jerryryle/a-roma/ABOUT.md

# About A-Roma (August 2025)

You can find more technical detail in [README.md](/README.md).

I thought it would be fun to prank my boss when he came back from a two-week vacation to Italy. While he was gone, my coworkers decorated his desk with an Italian theme. I decided that his desk also needed a way to dispense Italian-themed smells and music so that he could enjoy the sights, sounds, and smells of his trip when he returned.

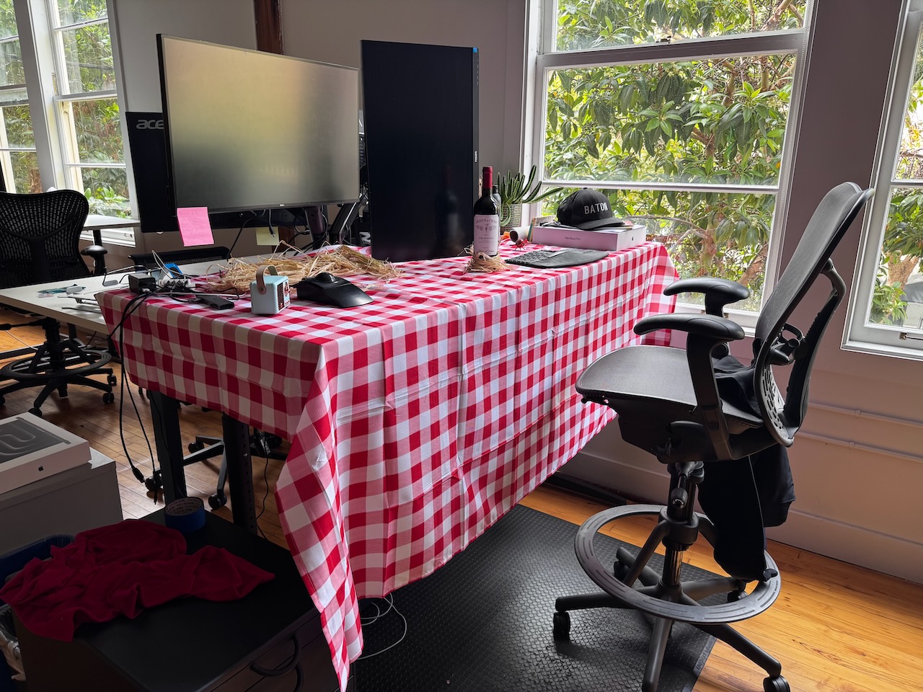
[picture p1: media/img-desk.jpeg]
My boss's desk Photo of my boss's desk, decorated with an Italian theme


The night before he returned, I loaded the device with scents and mounted it under his desk.

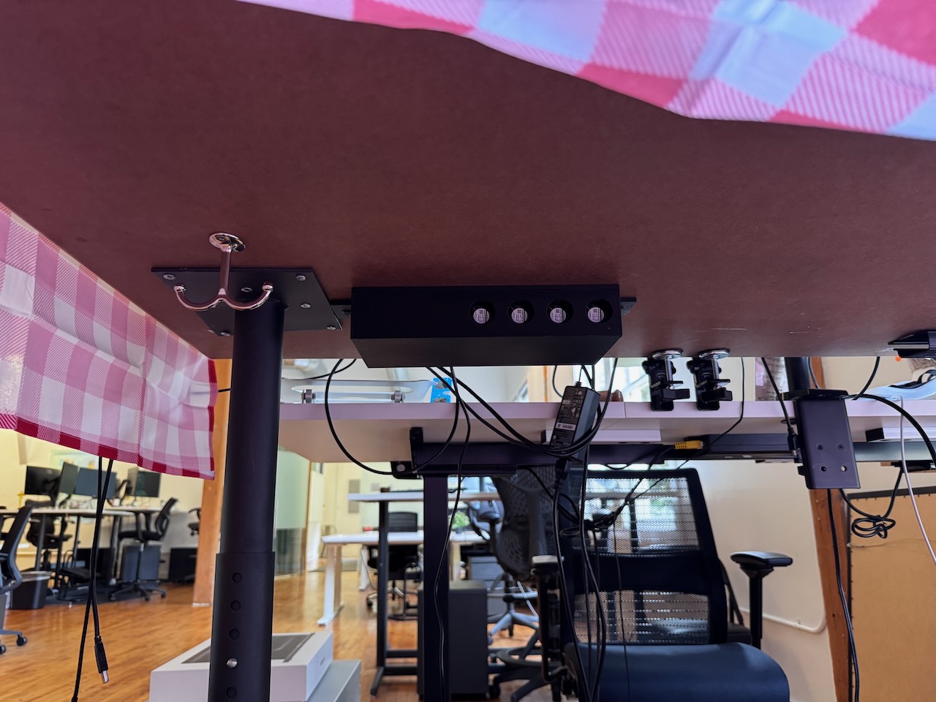
[picture p2: media/img-mounted.jpeg]
The device mounted under his desk Photo of the device mounted under his desk


The morning my boss returned, I created a private Slack channel that included everyone in the company except him. I told everyone what was happening and gave them the link to the device's website that they could use to trigger the dispensation of smells. And they did. Relentlessly. We had hours of fine Italian leather, artisan bread, espresso, and garlic. It backfired a bit since my boss was in meetings most of the day and I was sitting downwind of his desk. But we did see him sniffing around and asking others if they smelled something weird.

I had anticipated that there was a good chance he wouldn't go looking for the source of the smells and find the box, so I built in an escalation feature to help him discover it. This included a small speaker and software to play four campy Italian songs.

After a day of gassing the office, I finally decided to bring it to an end. I distributed a new link to everyone that added buttons to trigger the songs. It so happened that I chose songs he had loaded onto his phone for his trip. When they started playing, he thought they were coming from his phone and grabbed it to shut them off. When he realized his phone wasn't playing them, he started searching around his desk (while we madly blasted garlic), found the box, and yanked the power cord. The whole office was laughing at this point. I could hardly breathe--mostly from laughing, but also because of the garlic.

To wrap it up, I invited him into the Slack channel where he could see all of our plotting throughout the day. In that channel, I had posted a “making of” thread that went into detail about how I designed and built the device. Enjoy that below.

## The Making Of
The project began with reconnaissance to see how much space I had to work with. I needed dimensions for the area and to evaluate the angle of approach to ensure the box wasn't too deep or obvious. At this point, I didn't know the table would sport a tablecloth to help hide it.

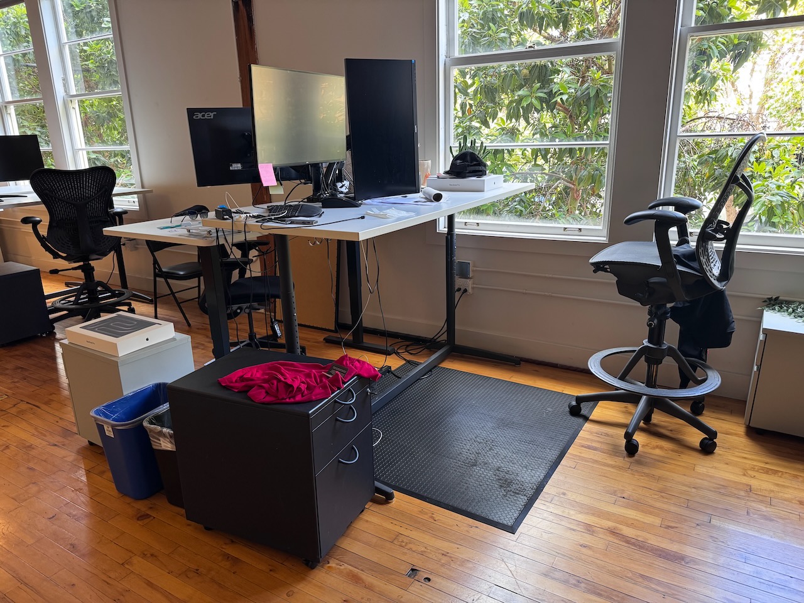
[picture p3: media/img-measuring-ryans-desk-approach.jpeg]
Checking out the angle of approach Photo of my boss's desk as one would walk up to it


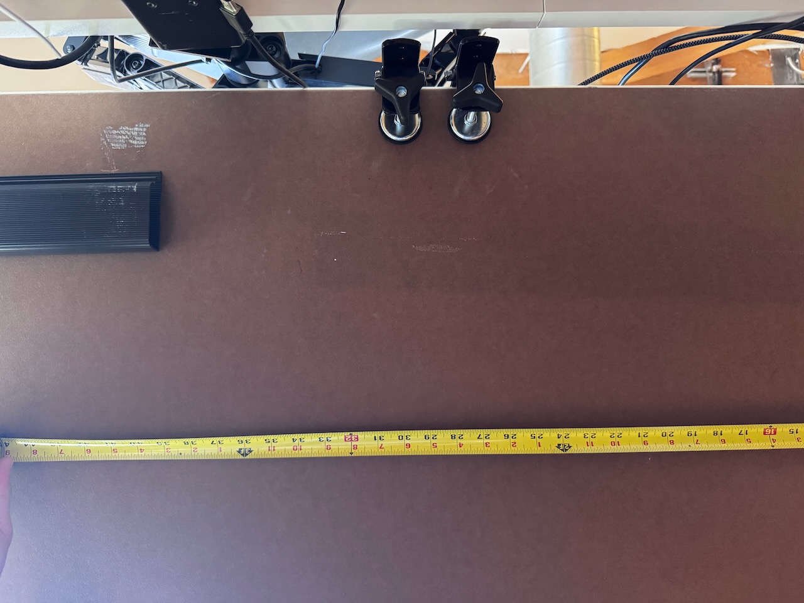
[picture p4: media/img-measuring-ryans-desk.jpeg]
Measuring how much space I had to work with Photo of holding a tape measure under the desk


Then I had to find small, quiet fans that moved a reasonable amount of air.

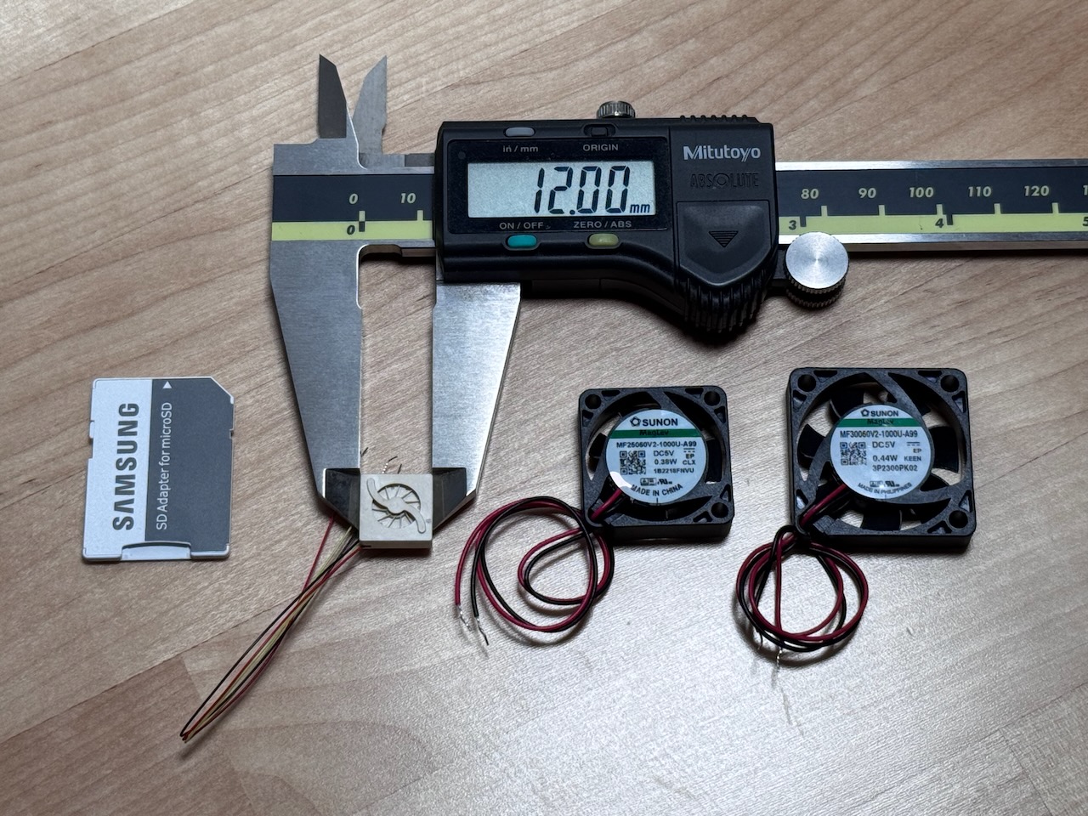
[picture p5: media/img-fan-sizing.jpeg]
I got an assortment of fan sizes Photo of fans of varying size


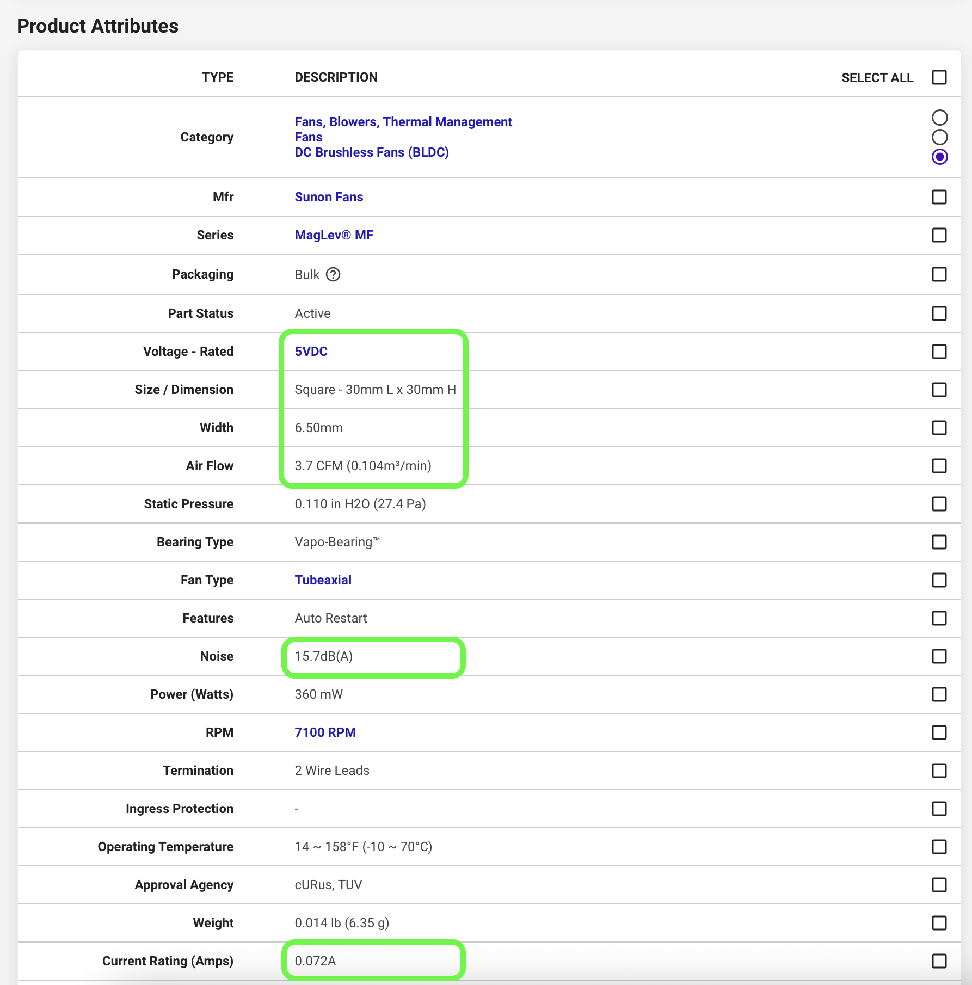
[picture p6: media/img-digikey-fan.png]
Inspecting relevant fan specifications Screenshot of DigiKey page with voltage, size, width, air flow, noise, and current rating circled


That tiny fan was ridiculous.

I modeled each aroma channel, anchoring around the fan size.

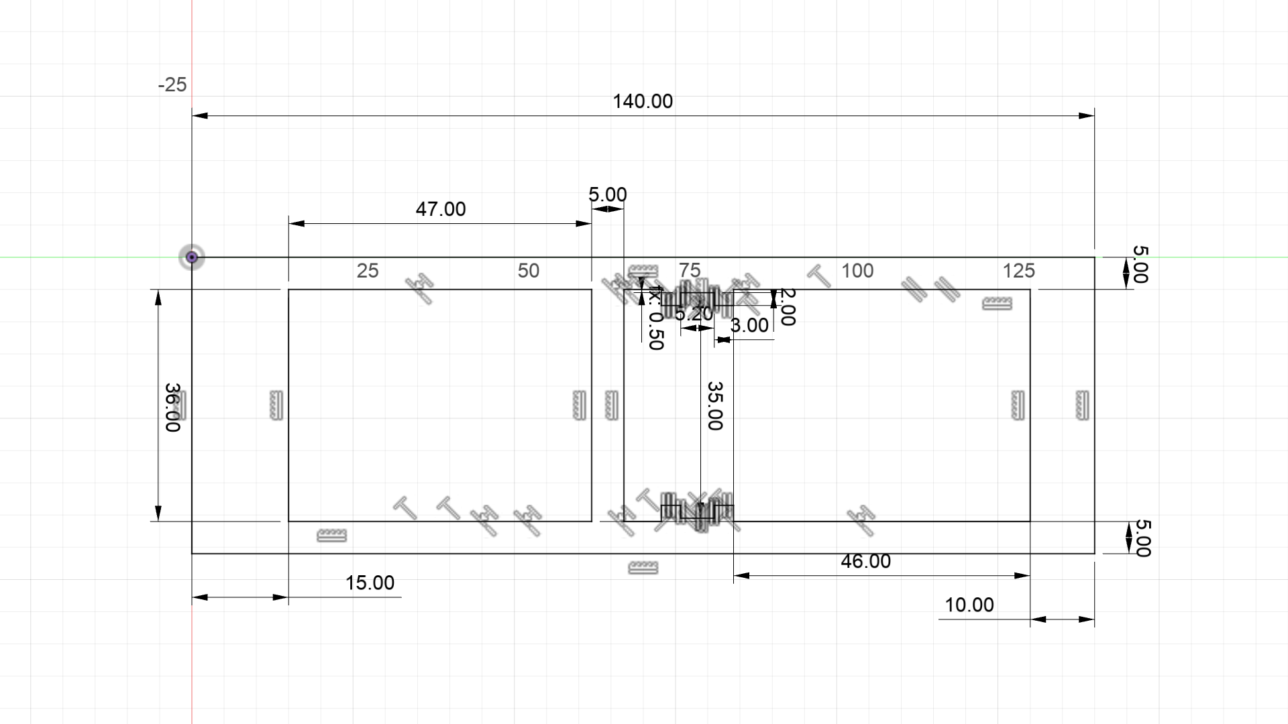
[picture p7: media/2D-chassis-channel.png]
Drawing of the aroma channel Screenshot of a 2D CAD drawing of the aroma channel


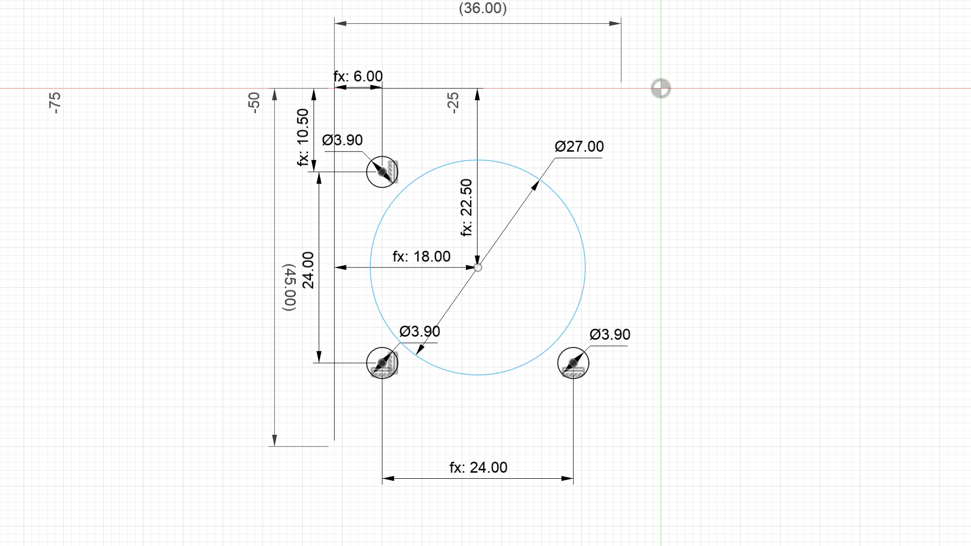
[picture p8: media/2D-chassis-fan.png]
Drawing of the fan cutout and mounting holes Screenshot of a 2D CAD drawing of the fan cutout and mounting holes


I found some aromatherapy oil pads that were roughly the size of the fan.

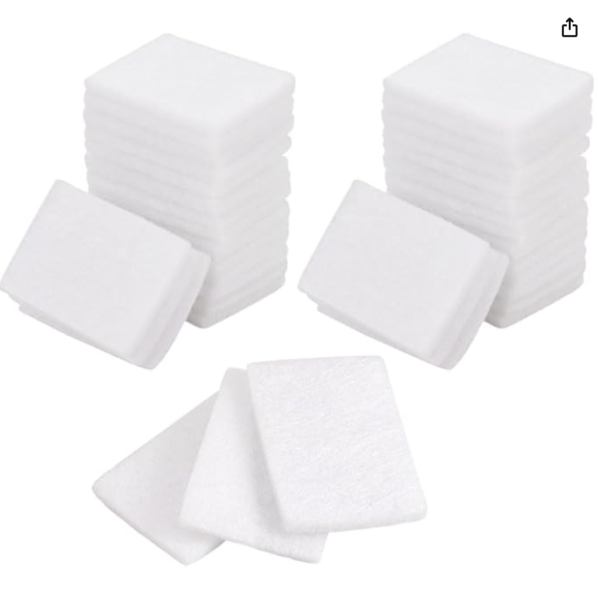
[picture p9: media/img-aromatherapy-pads.png]
Aromatherapy pads Photo of stacks of aromatherapy pads


And modeled a holder for them.

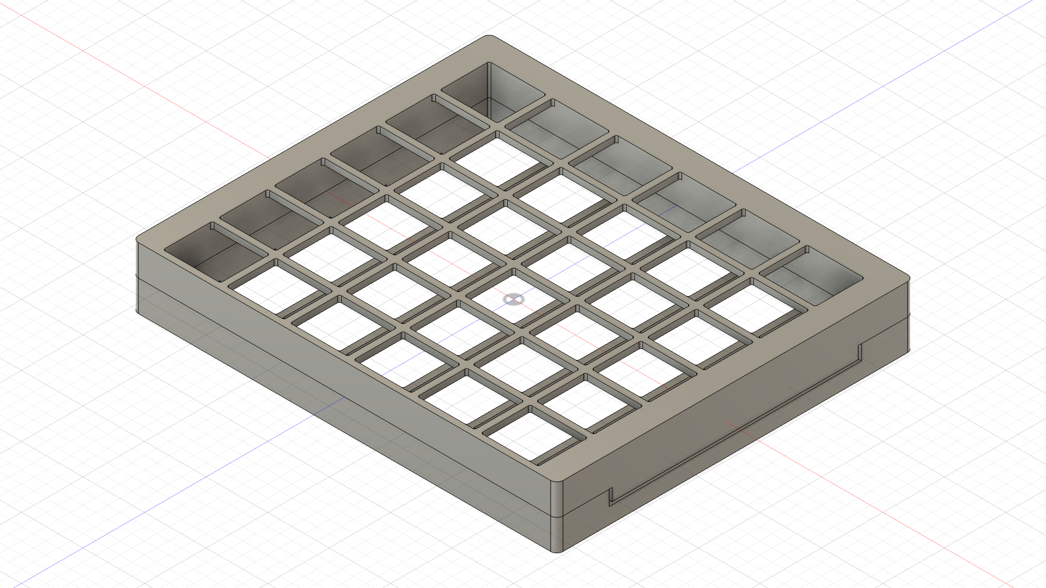
[picture p10: media/3D-filter-holder.png]
Pad holder Screenshot of a 3D CAD rendering of the pad holder


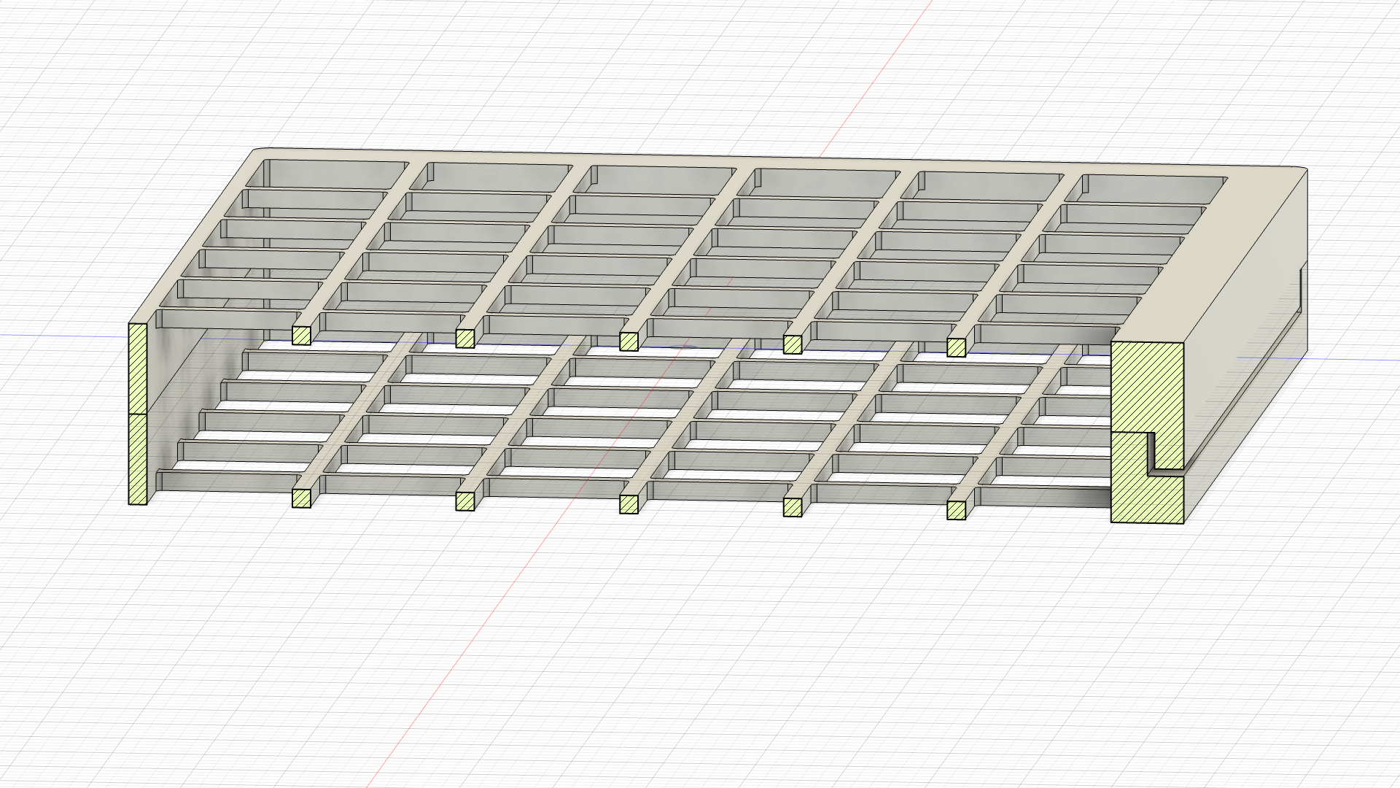
[picture p11: media/3D-filter-holder-section-analysis.png]
Pad holder section analysis Screenshot of a 3D CAD rendering of the pad holder, sliced to show how the two halves mate


The chassis is an array of four channels modeled around the fans and oil pads, with a separate space for the electronics.

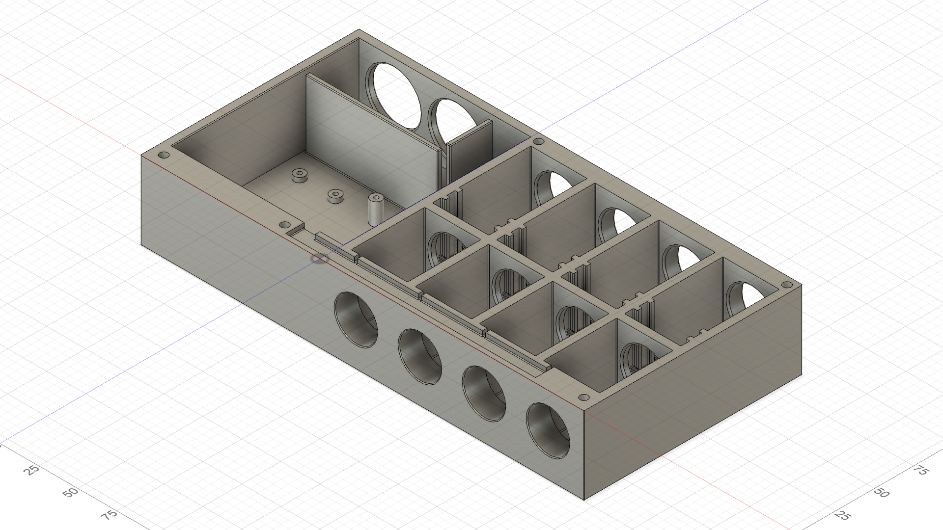
[picture p12: media/3D-chassis.png]
Chassis Screenshot of a 3D CAD rendering of the chassis


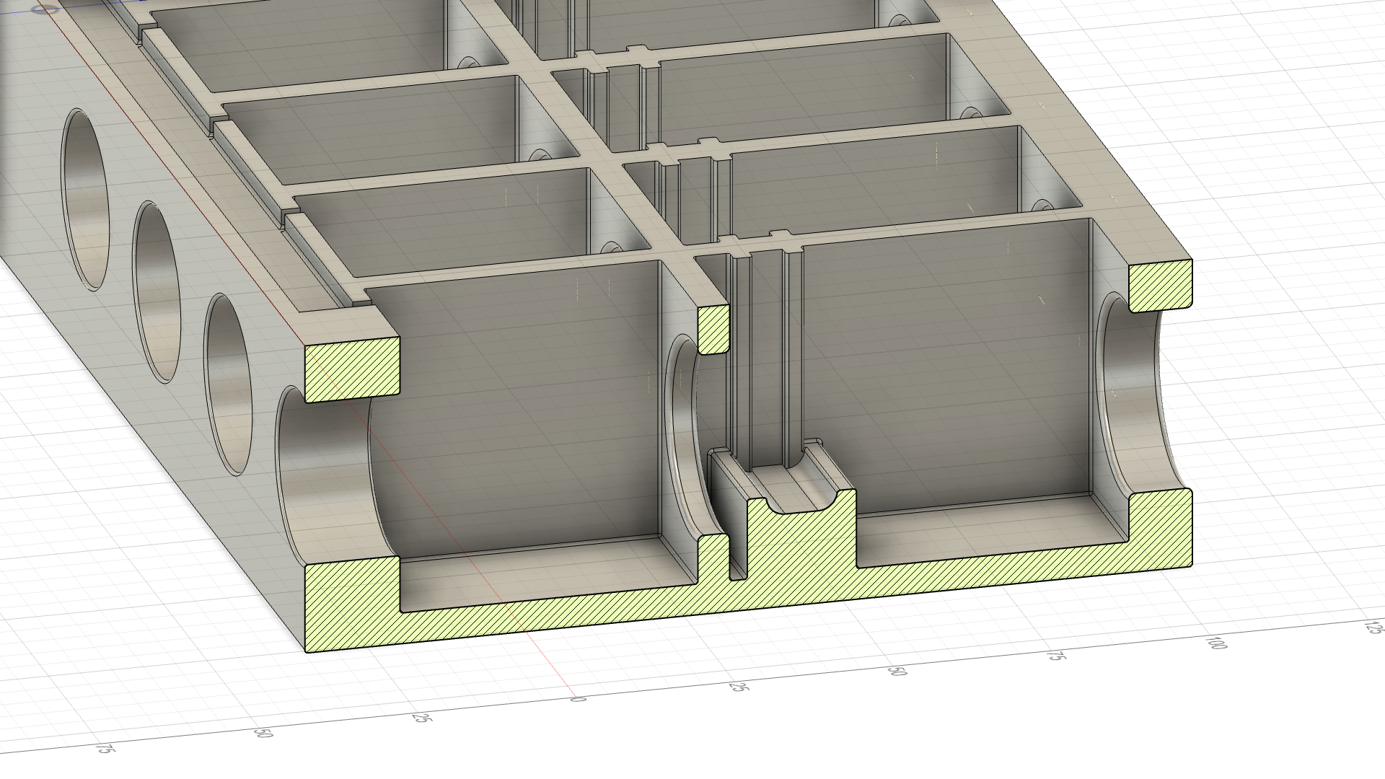
[picture p13: media/3D-chassis-section-analysis.png]
Chassis section analysis Screenshot of a 3D CAD rendering of the pad holder, sliced to show the channel details


I printed the chassis, lid, and oil pad holders with PETG plastic, one of the more oil-resistant plastics that's not too difficult to 3D print.

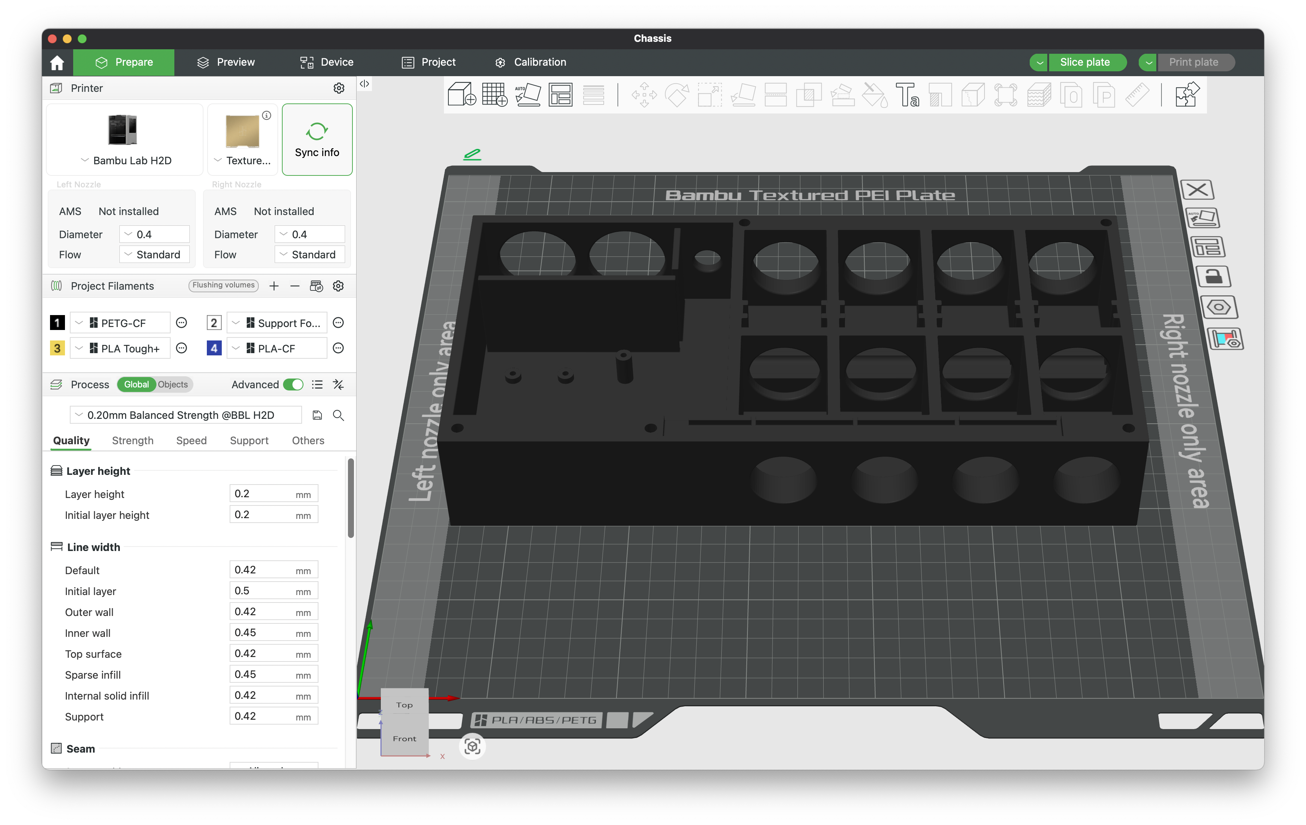
[picture p14: media/bambu-3dprint-chassis.png]
Chassis print preparation Screenshot of the Chassis in Bambu Studio


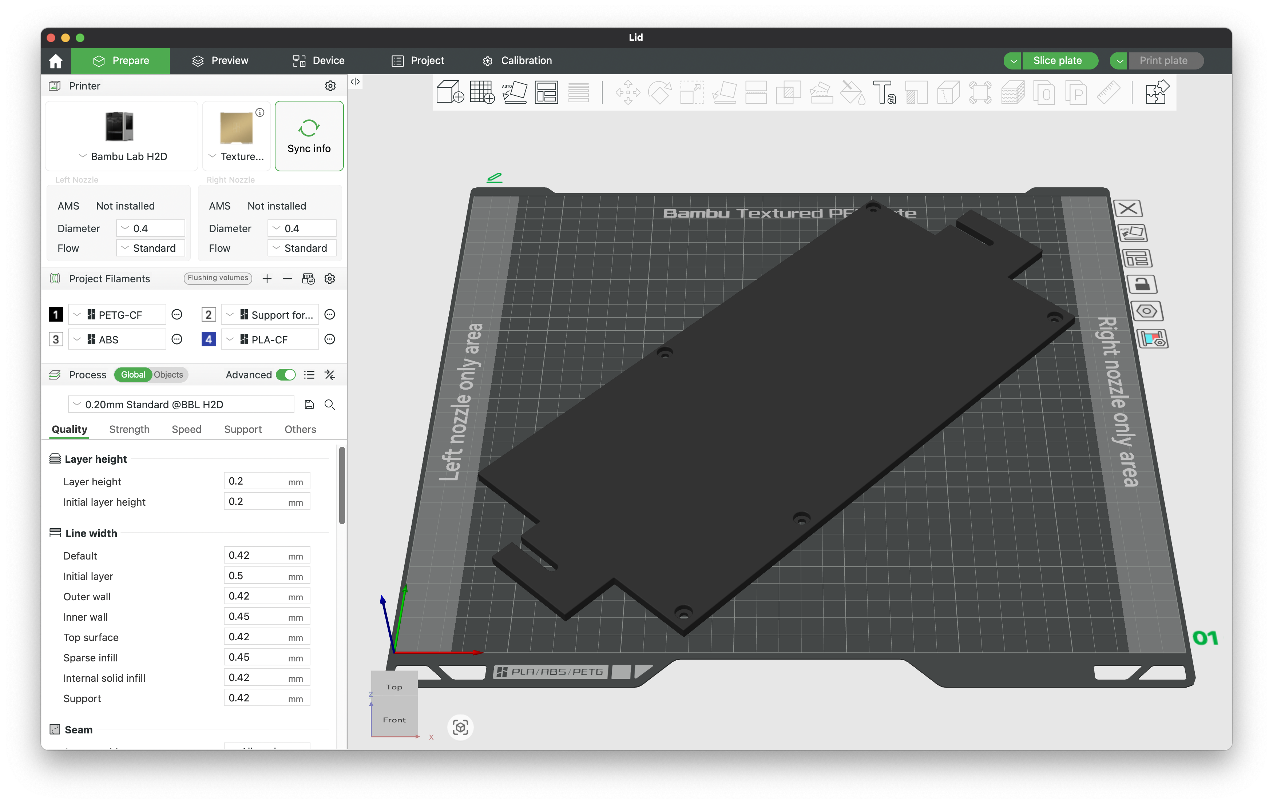
[picture p15: media/bambu-3dprint-lid.png]
Lid print preparation Screenshot of the Lid in Bambu Studio


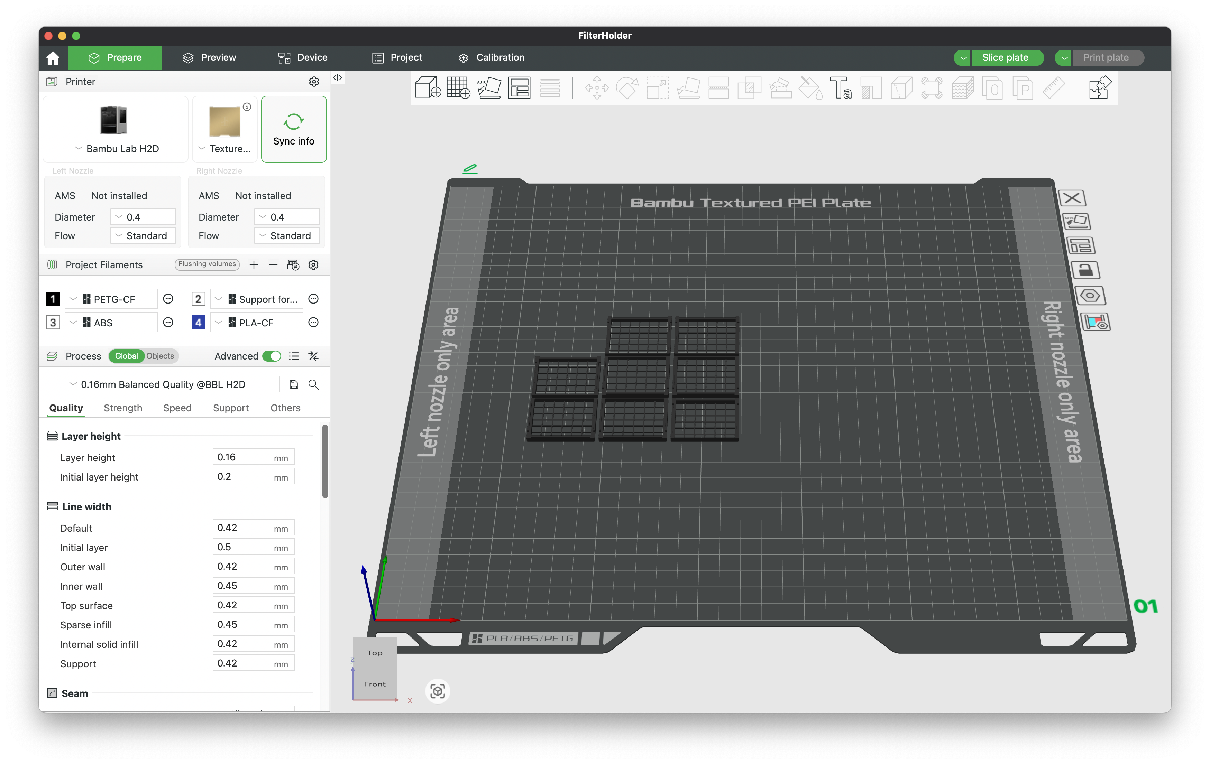
[picture p16: media/bambu-3dprint-filter-holder.png]
Pad holder print preparation Screenshot of the Pad Holders in Bambu Studio


These were all printed on a Bambu Labs H2D, which takes time lapses of the prints.

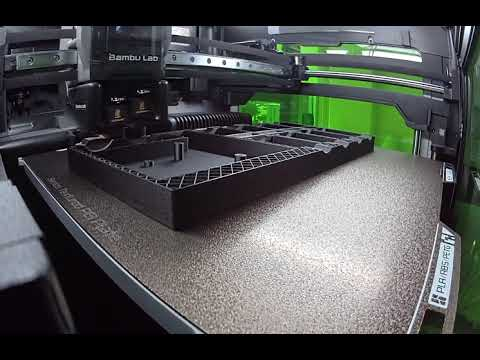
[picture p17: media/img-print-chassis-final.jpeg]
Chassis Time lapse video of the Chassis 3D printing (https://youtu.be/BnPhF0Df4So)


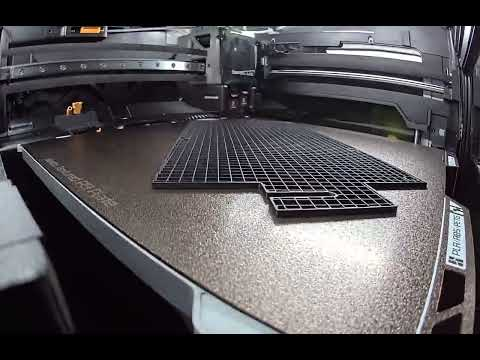
[picture p18: media/img-print-lid-final.jpeg]
Lid Time lapse video of the Lid 3D printing (https://youtu.be/3ELbYYBSLHE)


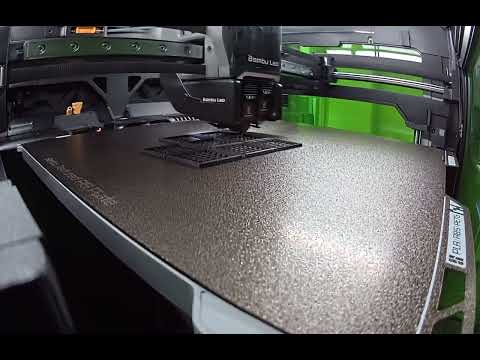
[picture p19: media/img-print-filter-holder-final.jpeg]
Pad holder Time lapse video of the Pad Holders 3D printing (https://youtu.be/F5UshDJUx3w)


The electronics are a Raspberry Pi Zero 2 W with a hand-soldered protoboard on top to drive the fans. I couldn't quickly find a suitable existing Raspberry Pi HAT for this application, so I made one.

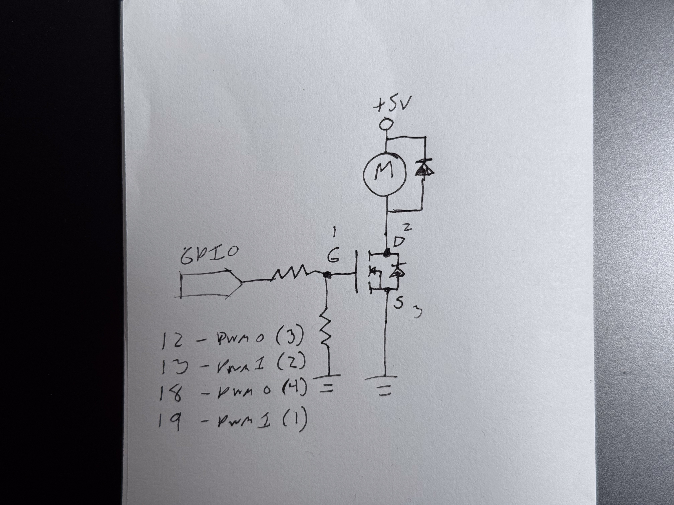
[picture p20: media/img-schematic.jpeg]
Fan drive schematic Photo of a hand-drawn schematic


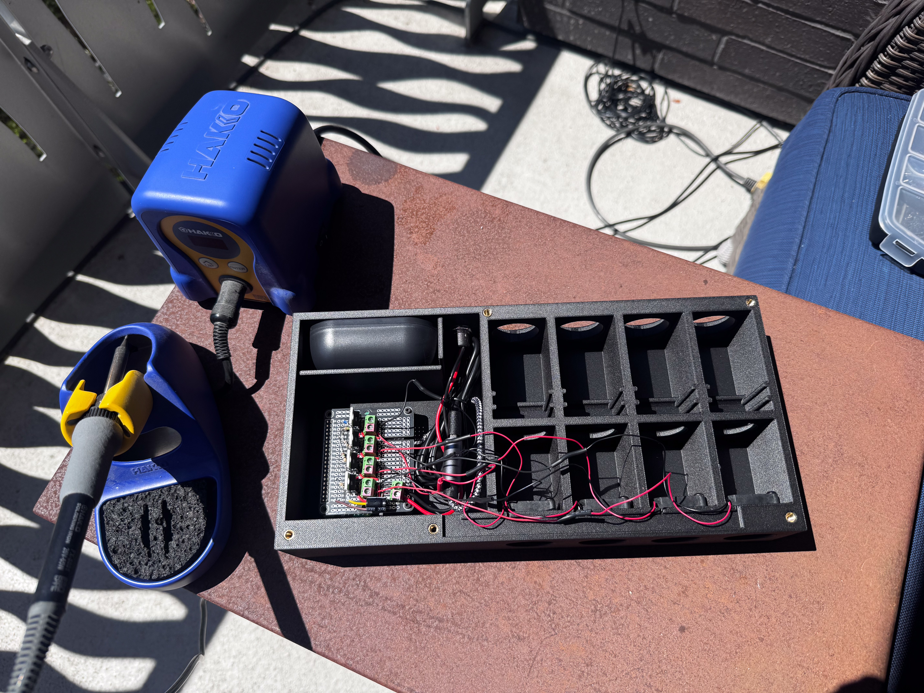
[picture p21: media/img-assembling.jpeg]
Wiring everything up Photo of the device with its wiring and circuit boards visible, next to a soldering iron


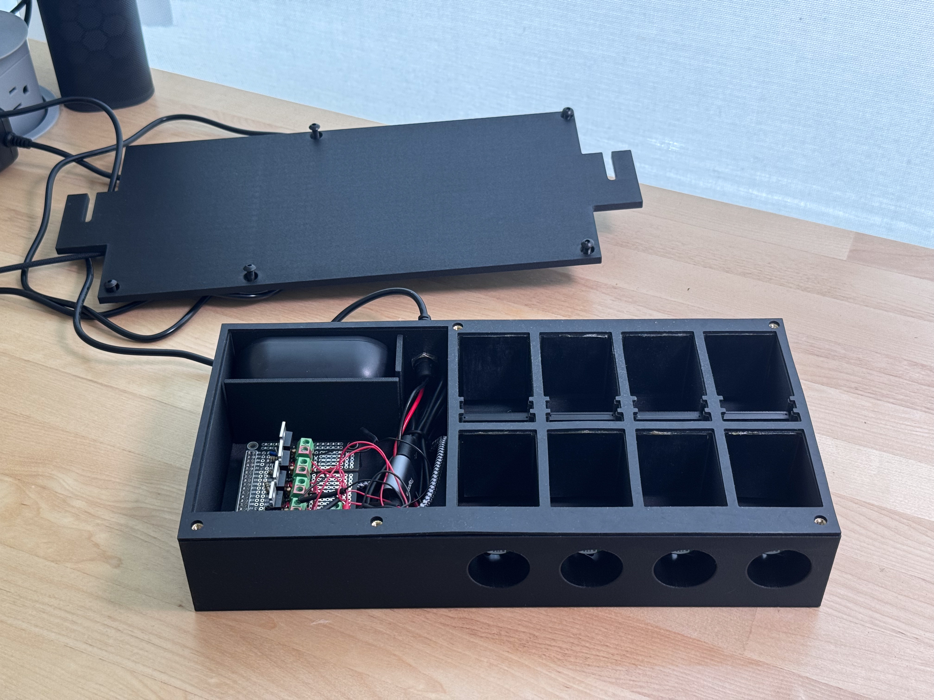
[picture p22: media/img-assembled.jpeg]
Assembled Photo of the device assembled and neater looking, with the lid off and next to the device


The oil pad chamber has valves over the inlet and outlet to reduce scent leakage. I had to ensure the fans could pull them open. This video shows a smoke test to see if it worked (this was after the smoke test to ensure my hand-soldered electronics didn't smoke).

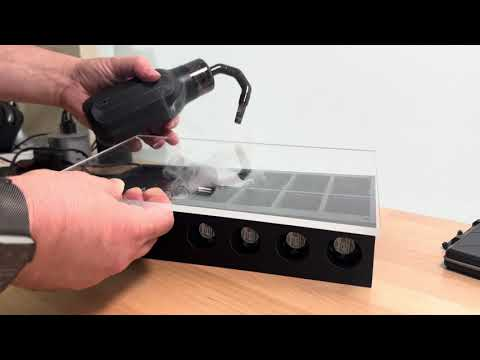
[picture p23: media/img-chassis-flow-test.jpeg]
Smoke test Video of me putting smoke into one of the chambers with a handheld smoke generator, covering with acrylic, and demonstrating that the fan pulls the smoke out of the chamber (https://youtu.be/E1qMsYYkDR8)


I laser cut a gasket to help seal the chambers. I do not recommend laser-cutting rubber--that was the worst scent in this whole adventure.

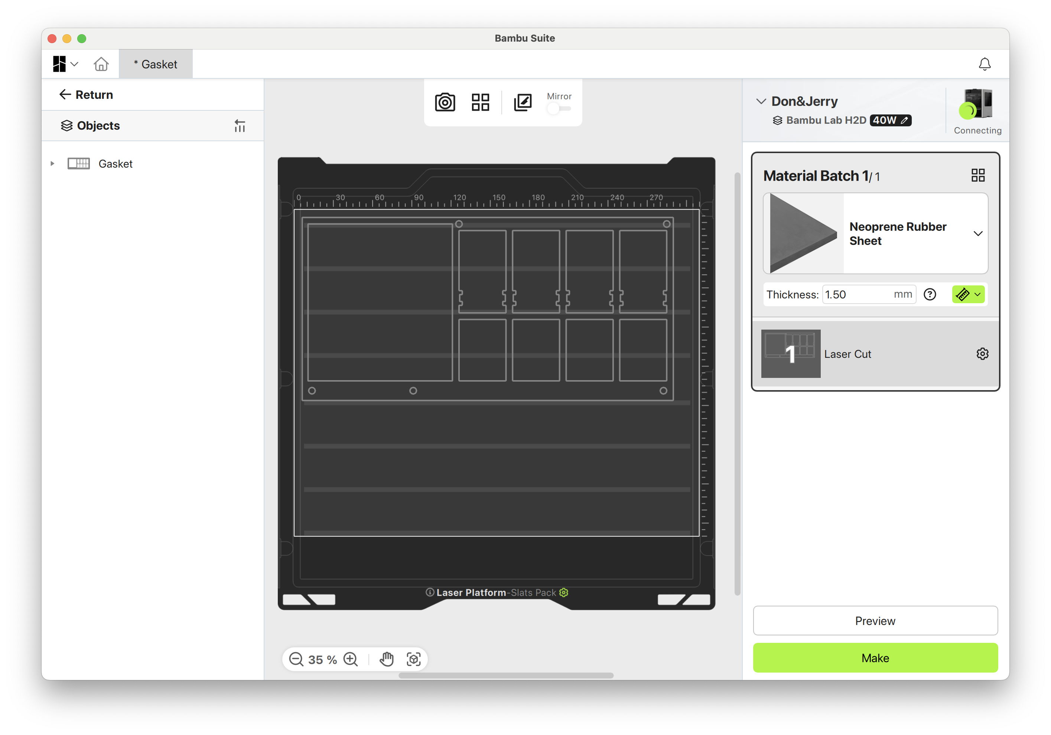
[picture p24: media/bambu-laser-cut-gasket.png]
Gasket laser cut preparation Screenshot of the gasket in Bambu Suite


The web app is a Python back-end running on the RPi and static HTML on the front end, using tailwind.css for styling. I largely vibe-coded the HTML by giving Cursor this mock-up image. I had to do more hand-coding on the back-end since Cursor kept generating garbage there.

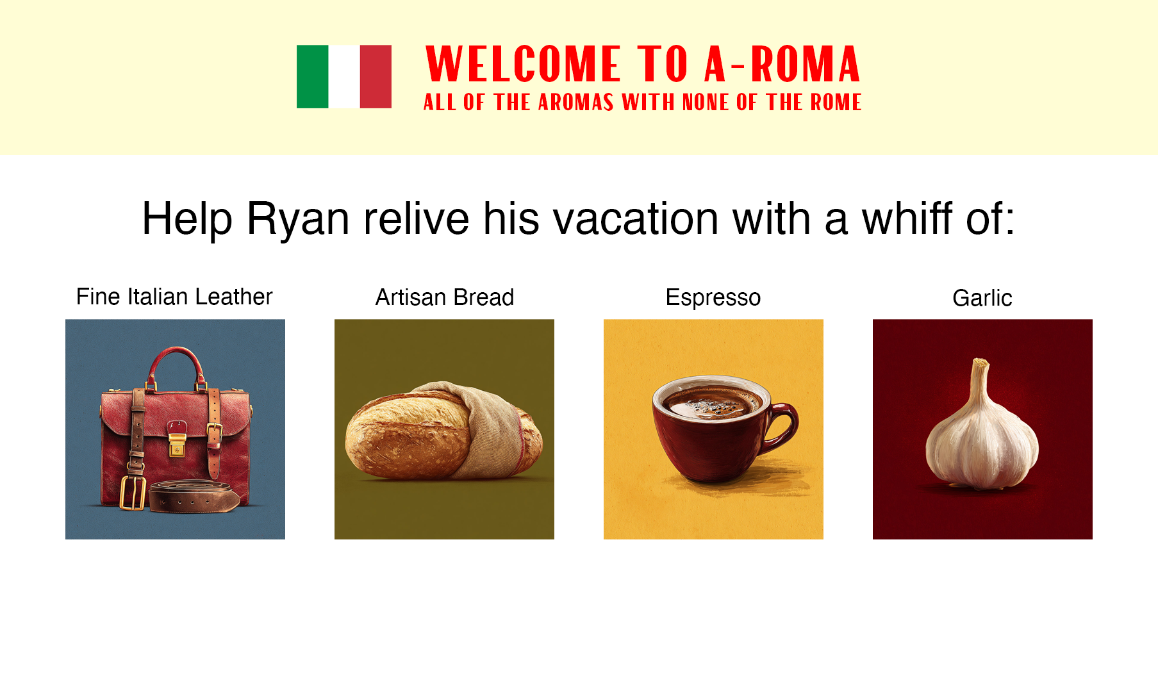
[picture p25: media/web-ui-mock.png]
Mock-up I created in Photoshop Image of a website mock-up with 4 buttons representing different scents


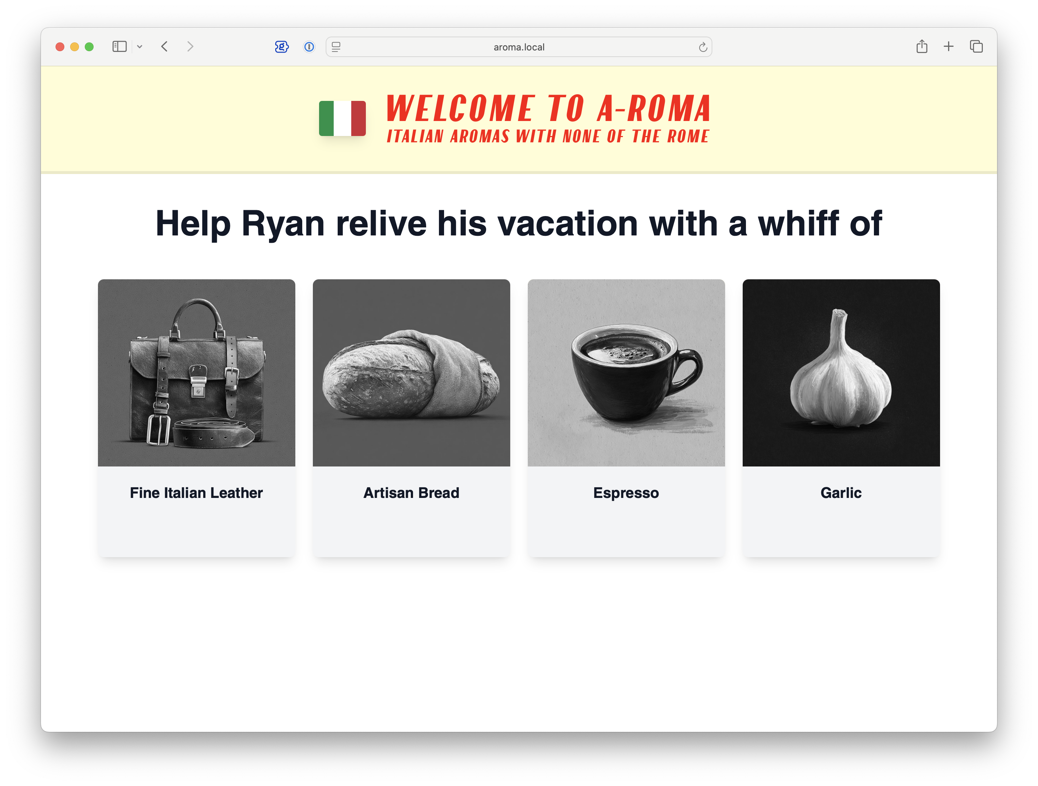
[picture p26: media/web-ui-basic.png]
The final website Screenshot of a website with 4 buttons to dispense different scents


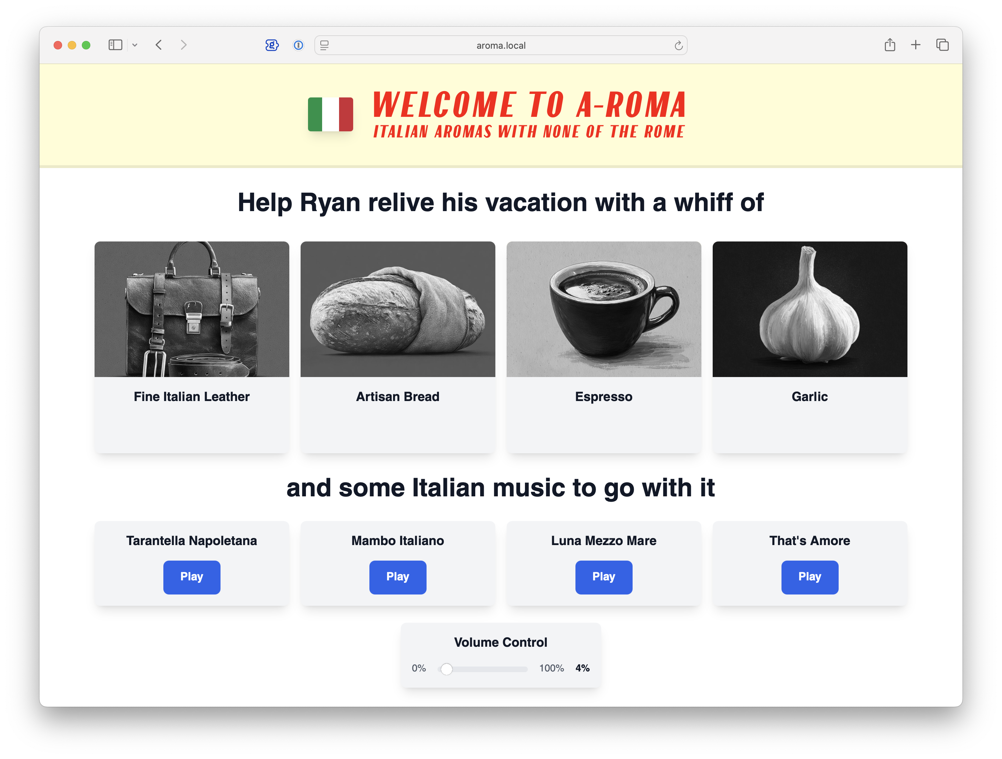
[picture p27: media/web-ui-escalate.png]
The final website - escalation edition Screenshot of a website with 4 buttons to dispense different scents and 4 buttons to play different songs


I oiled it up before installing it.

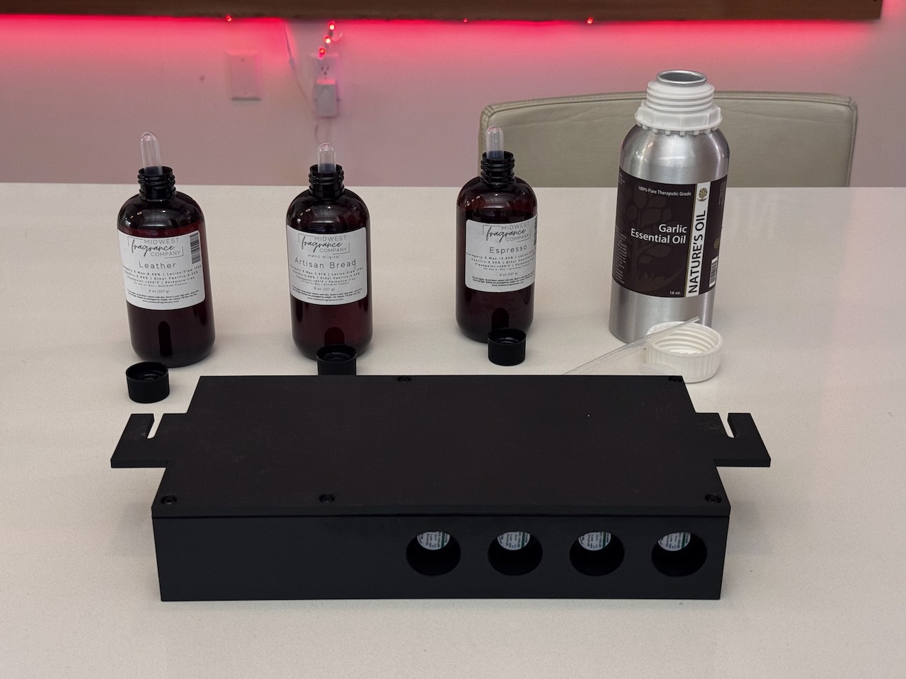
[picture p28: media/img-oiling-up.jpeg]
Oiling up Photo of the device, fully assembled, with four oil jars behind it


I mounted it under his desk with two screws and washers.

Mounted Photo of the device, assembled and mounted under the desk

This was a very fun project that kept my nights and weekends occupied for a couple of weeks.
