jerryryle/a-roma/static/android-chrome-192x192.png

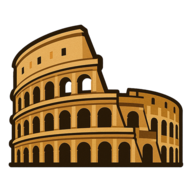
static/android-chrome-192x192.png
