jerryryle/a-roma/static/bread.jpg

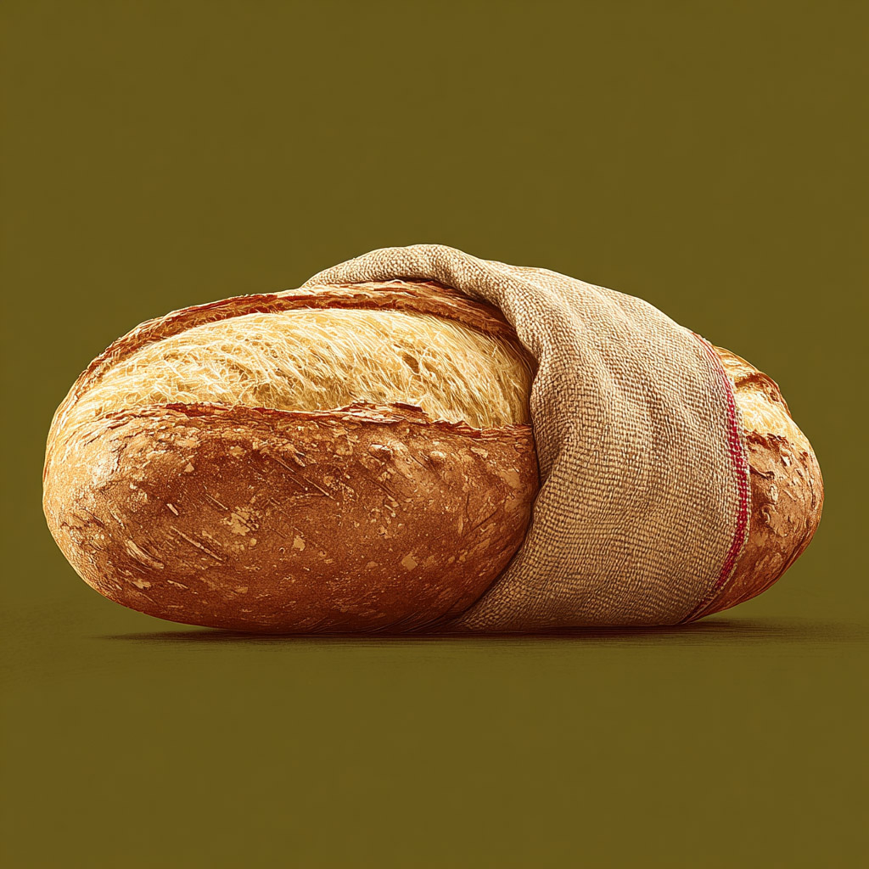
static/bread.jpg
