jerryryle/a-roma/static/espresso.jpg

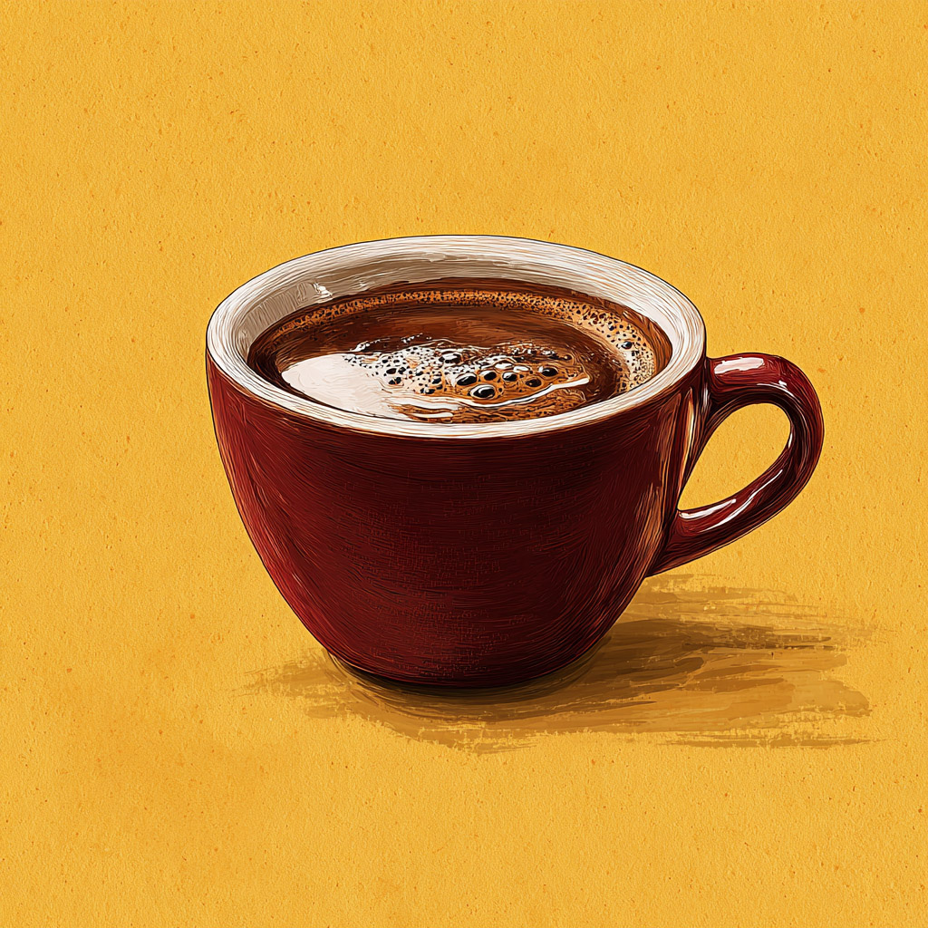
static/espresso.jpg
