jerryryle/a-roma/static/garlic.jpg

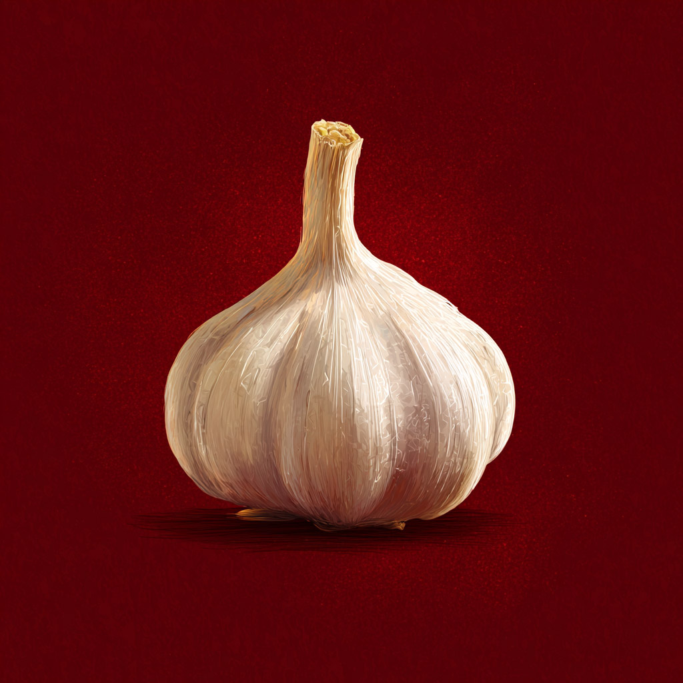
static/garlic.jpg
