jerryryle/a-roma/static/leather.jpg

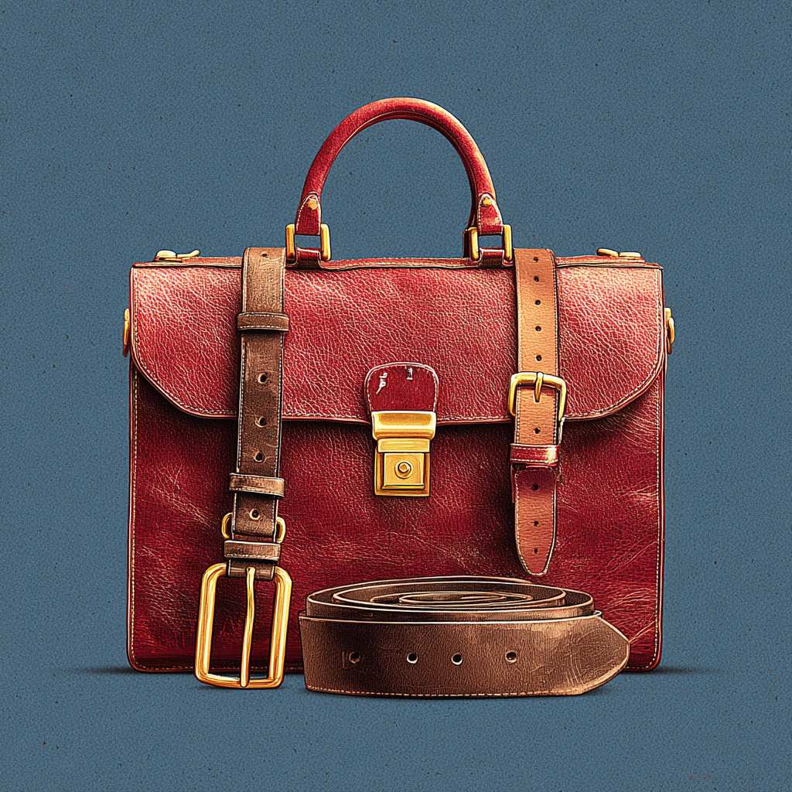
static/leather.jpg
