jerryryle/a-roma/cad/3d/Lid.3mf

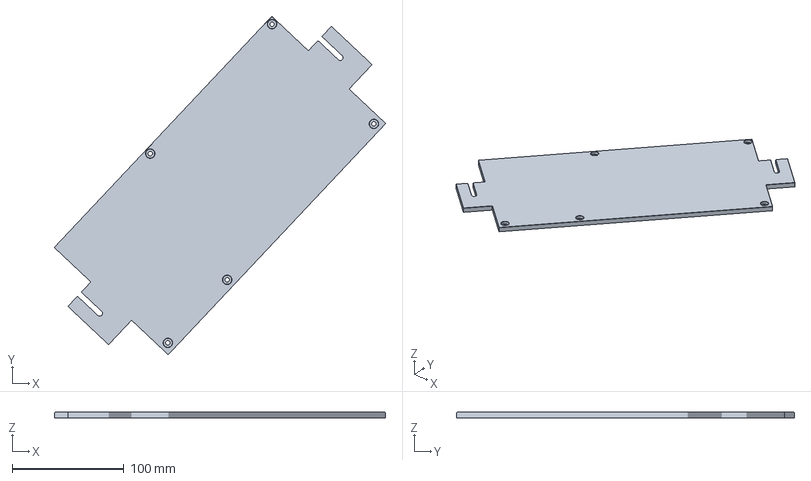
[picture p34: CAD file, 2025-10-25]
cad/3d/Lid.3mf
296.2 x 302.4 x 5.00 mm
