jerryryle/a-roma/cad/3d/FilterHolder.3mf

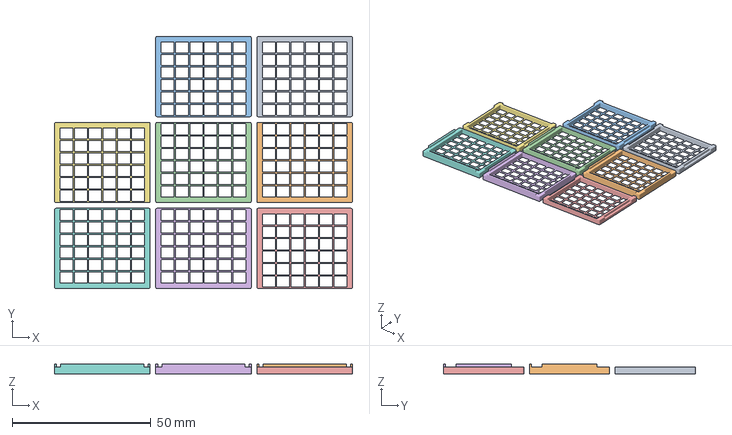
[picture p35: CAD file, 2025-10-25]
cad/3d/FilterHolder.3mf
107.5 x 91.0 x 3.50 mm
FilterHolderBottom x 4
FilterHolderTop x 4
