jerryryle/a-roma/cad/3d/Chassis.3mf

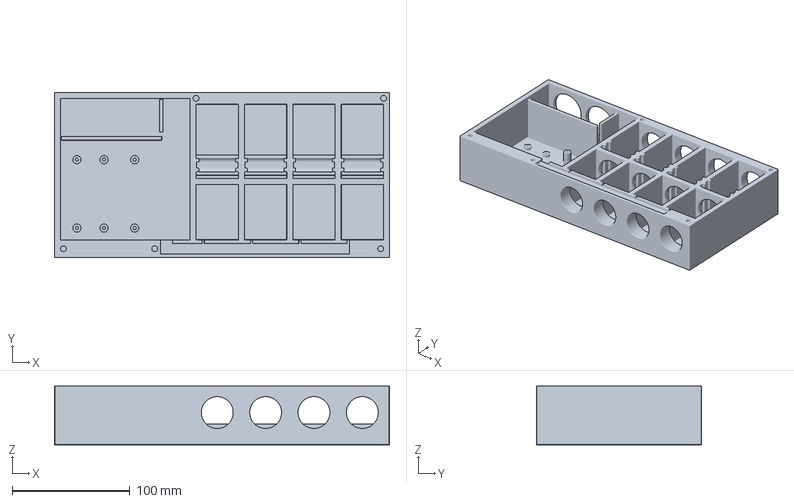
[picture p36: CAD file, 2025-10-25]
cad/3d/Chassis.3mf
284.0 x 140.0 x 50.0 mm
