jerryryle/a-roma/(list of files, cad)

Other CAD files:
cad/3d/Oil Filter v14.f3d
cad/3d/a-roma v18.f3d
