jerryryle/a-roma/src/aroma_software/logger_setup.py

# Standard Library Imports
import logging
import os
from logging.handlers import RotatingFileHandler


def setup_logger(log_file_path: str) -> logging.Logger:
    # Ensure the directory exists
    log_dir = os.path.dirname(log_file_path)
    if log_dir:
        os.makedirs(log_dir, exist_ok=True)

    logger = logging.getLogger("")
    logger.setLevel(logging.INFO)
    logger.handlers.clear()

    formatter = logging.Formatter(
        "[%(asctime)s %(name)s] %(levelname)s %(message)s", "%Y-%m-%d %H:%M:%S"
    )

    file_handler = RotatingFileHandler(
        log_file_path,
        maxBytes=10 * 1024 * 1024,
        backupCount=5,
    )
    file_handler.setFormatter(formatter)
    logger.addHandler(file_handler)

    console_handler = logging.StreamHandler()
    console_handler.setFormatter(formatter)
    logger.addHandler(console_handler)

    return logger
