jerryryle/a-roma/(commit log)

2025-08-24 Fixed fans affecting each other and incorrect countdown timing
    [fan_controller.py]
2025-08-24 Increased escalate fan time.
2025-08-24 Reserve space for stop buttons to prevent page jumping
2025-10-25 Added 2d/3d CAD files
    [Chassis.3mf, FilterHolder.3mf, Lid.3mf, Oil Filter v14.f3d, a-roma v18.f3d]
2025-12-07 Reorganized repo
    [Chassis.3mf, FilterHolder.3mf, Lid.3mf, Oil Filter v14.f3d, a-roma v18.f3d]
2025-12-07 Added Illustrator files from early sizing exercise
    These were early sketches to prototype layout before I started CAD.
